Digital-Blocks-design/open_jtag_smt3/README.md

# open_jtag_smt3

已经过量产验证的 digilent jtag_smt3 仿真器开源版本 ，支持xilinx FPGA调试以及URAT接口 。
