Digital-Blocks-design/open_jtag_smt3/tools/USB_JTAG编程文件/readme.md

# USB_JTAG编程文件使用说明

【2024年2月10日】

如下图所示 ，该文件夹下有两个版本的编程文件，版本号分别为 **V1.0** 和 **V1.1** 。

编程文件

 **V1.0** 和 **V1.1** 的区别为用户自定义的仿真器编号定义不同 。

 **V1.0** ：用户需输入至少8个ASSCLL字符串 ，用作仿真器序列号 。

 **V1.1** ：用户需输入至少2个ASSCLL字符串 ，程序会计算当前日期的时间，并自动填充到仿真器序列号中 。

## V1.0 版本使用说明 :

1，通过USB线缆连接仿真器到电脑端 ，vivado软件的【HARDWARE MANAGER】功能需关闭。

2，（可选）使用 FT_Prog 工具检测电脑是否能够识别到器件。

3，双击运行【FT2232H EEPROM Modify.exe】程序 。

4，命令行窗口提示输入至少8个ASSCLL字符串（超过8个的字符串将被忽略）。

输入至少8个ASSCLL字符串

5，程序识别到2个设备 ，且两个设备的Type均为6 。

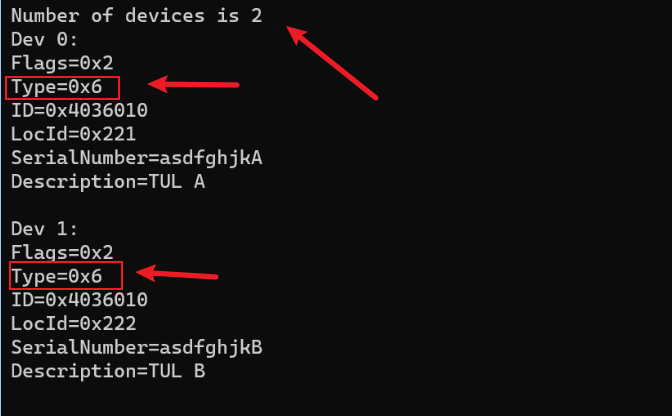
[picture p1: tools/USB_JTAG编程文件/image/图片2.png]
程序识别到2个设备


6，按下回车键，完成 EEPROM 程序烧录 ，终端显示 “Success write EEPROM”字符串 ，表示EEPROM 程序烧录成功 。

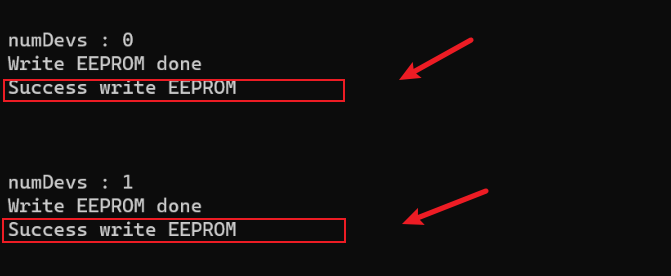
[picture p2: tools/USB_JTAG编程文件/image/图片3.png]
程序烧录成功


7，打开vivado软件，使用 【HARDWARE MANAGER】工具验证是否能识别到下载器工具 。

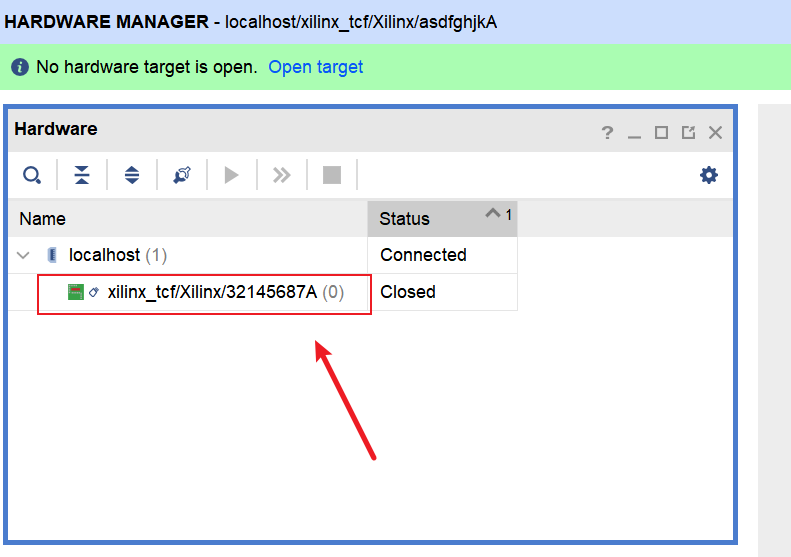
[picture p3: tools/USB_JTAG编程文件/image/图片4.png]
识别到下载器工具


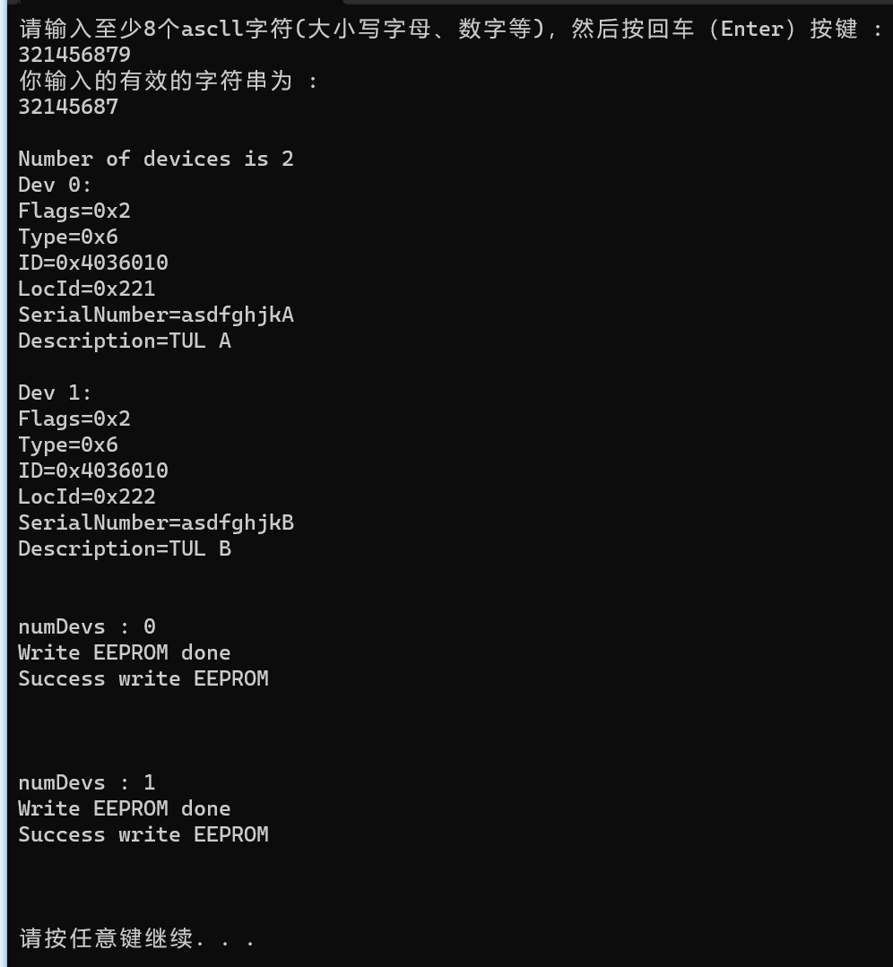
[picture p4: tools/USB_JTAG编程文件/image/图片5.png]
完整的编程日志
完整的编程日志如下 ：

## V1.1 更新内容 ： 

1. 命令行窗口提示输入至少2个ASSCLL字符串（超过2个的字符串将被忽略）。
2. 程序会计算当前日期的时间（年月日），并自动填充到仿真器序列号中 。
