Digital-Blocks-design/open_jtag_smt3/tools/USB_JTAG编程文件/使用说明.txt

【2023年10月26日12:13:39】
V1.0 ：
1，通过USB线缆连接仿真器到电脑端 ，vivado软件的【HARDWARE MANAGER】功能需关闭。
2，（可选）使用 FT_Prog 工具检测电脑是否能够识别到器件。
3，点击运行【FT2232H EEPROM Modify.exe】程序 。
4，命令行窗口提示输入至少8个ASSCLL字符串（超过8个的字符串将被忽略）。
5，按下回车键，完成 EEPROM 程序烧录 。
6，打开vivado软件，使用 【HARDWARE MANAGER】工具验证是否能识别到下载器工具 。

【2024年1月2日16:17:26】
V1.1 更新内容 ： 
命令行窗口提示输入至少2个ASSCLL字符串（超过2个的字符串将被忽略）。
程序会计算当前日期的时间（年月日），并自动填充到仿真器序列号中 。
