Digital-Blocks-design/open_jtag_smt3/doc/jtag-smt3-0.png

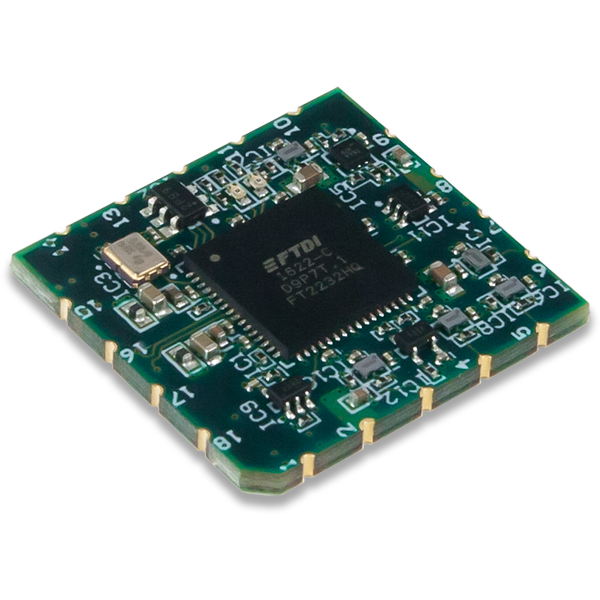
doc/jtag-smt3-0.png
