Digital-Blocks-design/open_jtag_smt3/doc/jtag-smt3-1.png

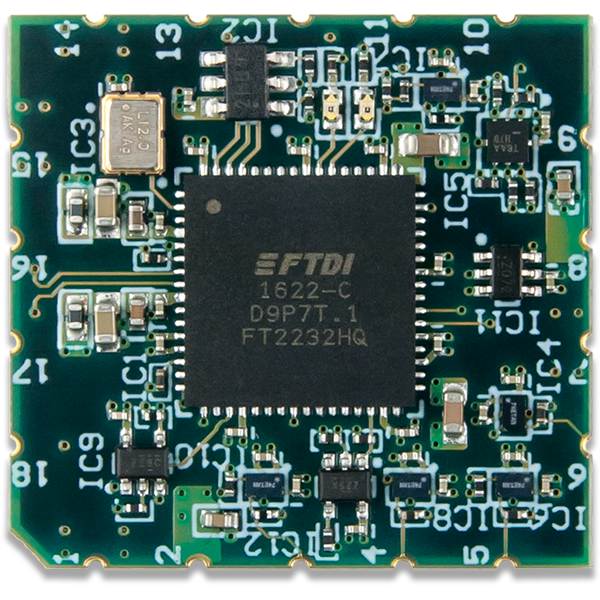
doc/jtag-smt3-1.png
