Digital-Blocks-design/open_jtag_smt3/doc/jtag-smt3-3.png

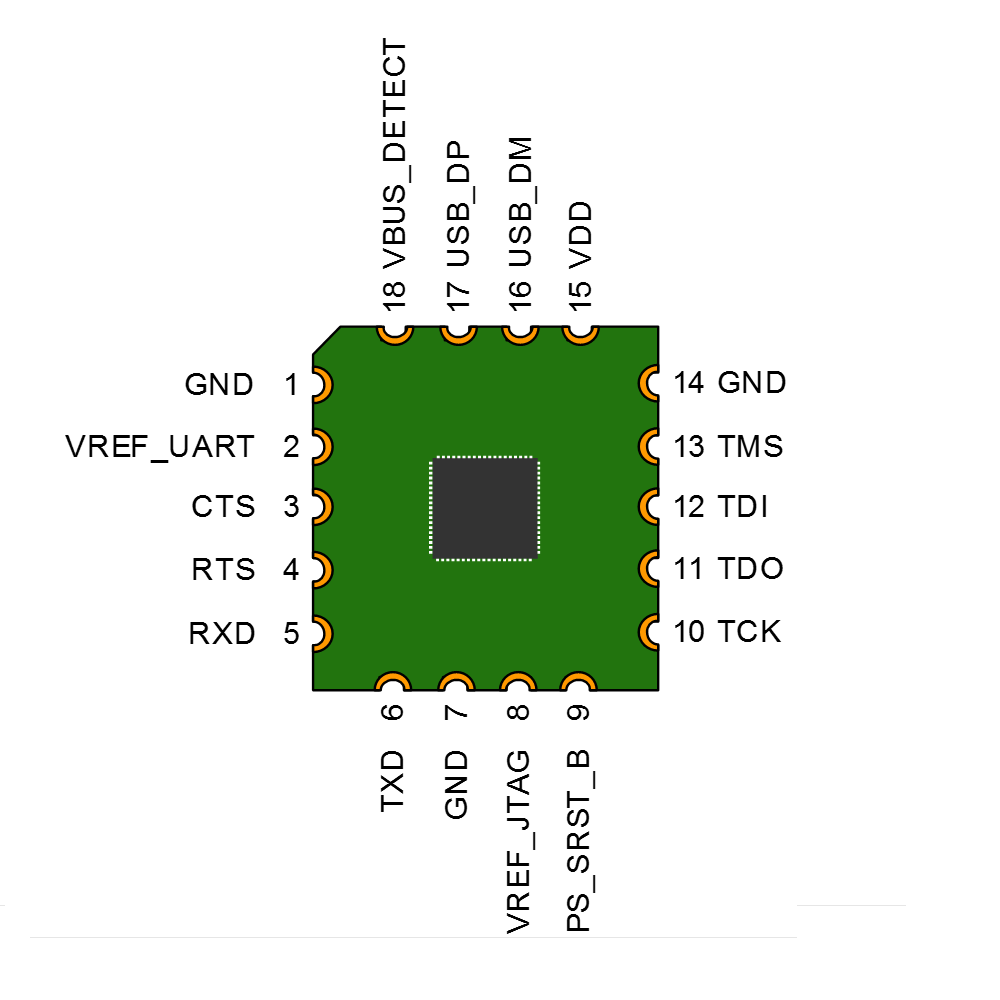
doc/jtag-smt3-3.png
