Digital-Blocks-design/open_jtag_smt3/hardware/image/JTAG插座结构/弯针/DC3弯针座_1.jpg

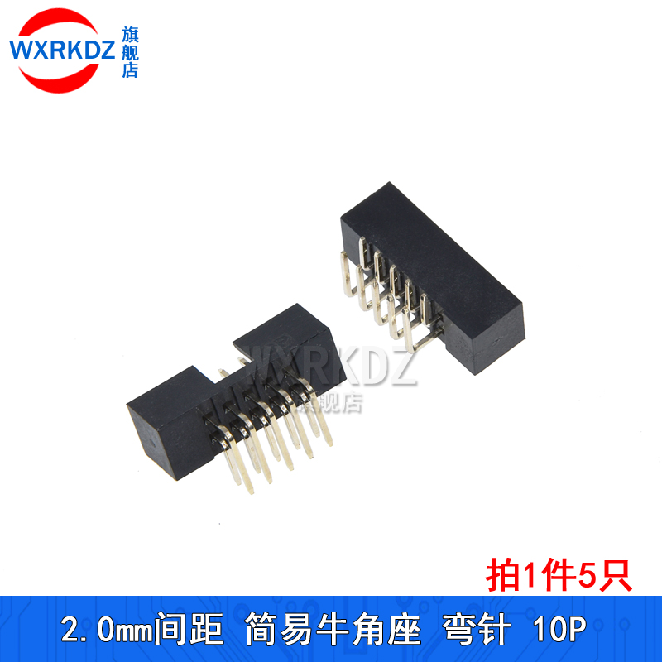
hardware/image/JTAG插座结构/弯针/DC3弯针座_1.jpg
