Digital-Blocks-design/open_jtag_smt3/hardware/image/JTAG插座结构/直针/DC3直针座_0.jpg

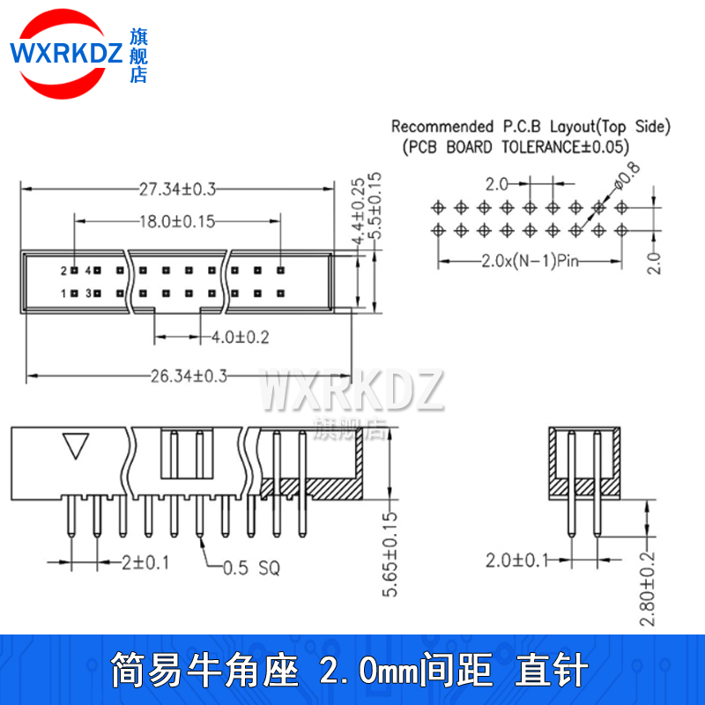
hardware/image/JTAG插座结构/直针/DC3直针座_0.jpg
