Digital-Blocks-design/open_jtag_smt3/hardware/image/USB_JTAG实物图_0.jpg

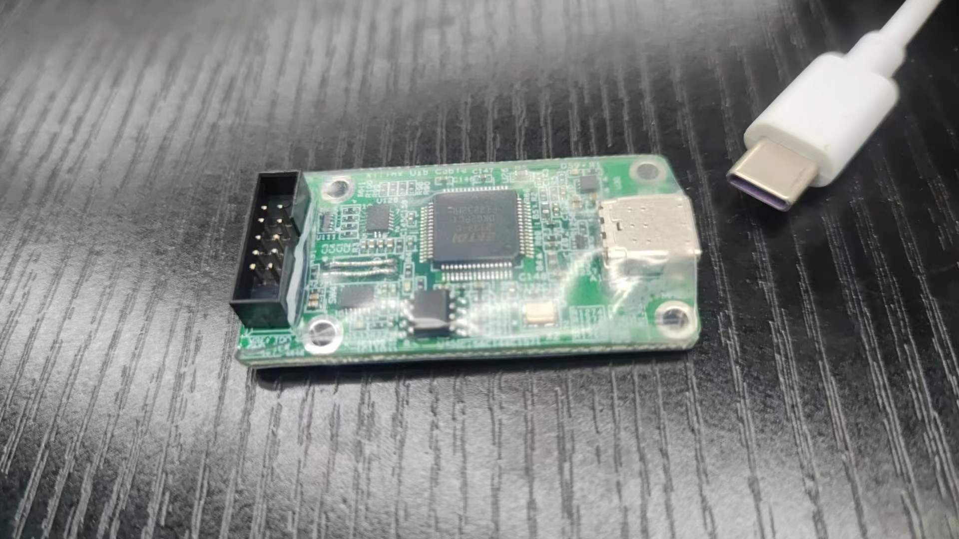
hardware/image/USB_JTAG实物图_0.jpg
