Digital-Blocks-design/open_jtag_smt3/hardware/image/USB_JTAG实物图_1.jpg

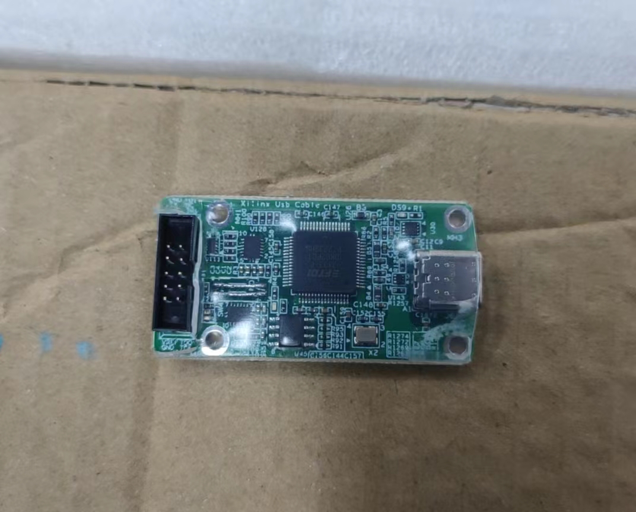
hardware/image/USB_JTAG实物图_1.jpg
