Digital-Blocks-design/open_jtag_smt3/hardware/PCB/PCB_TOP_1.png

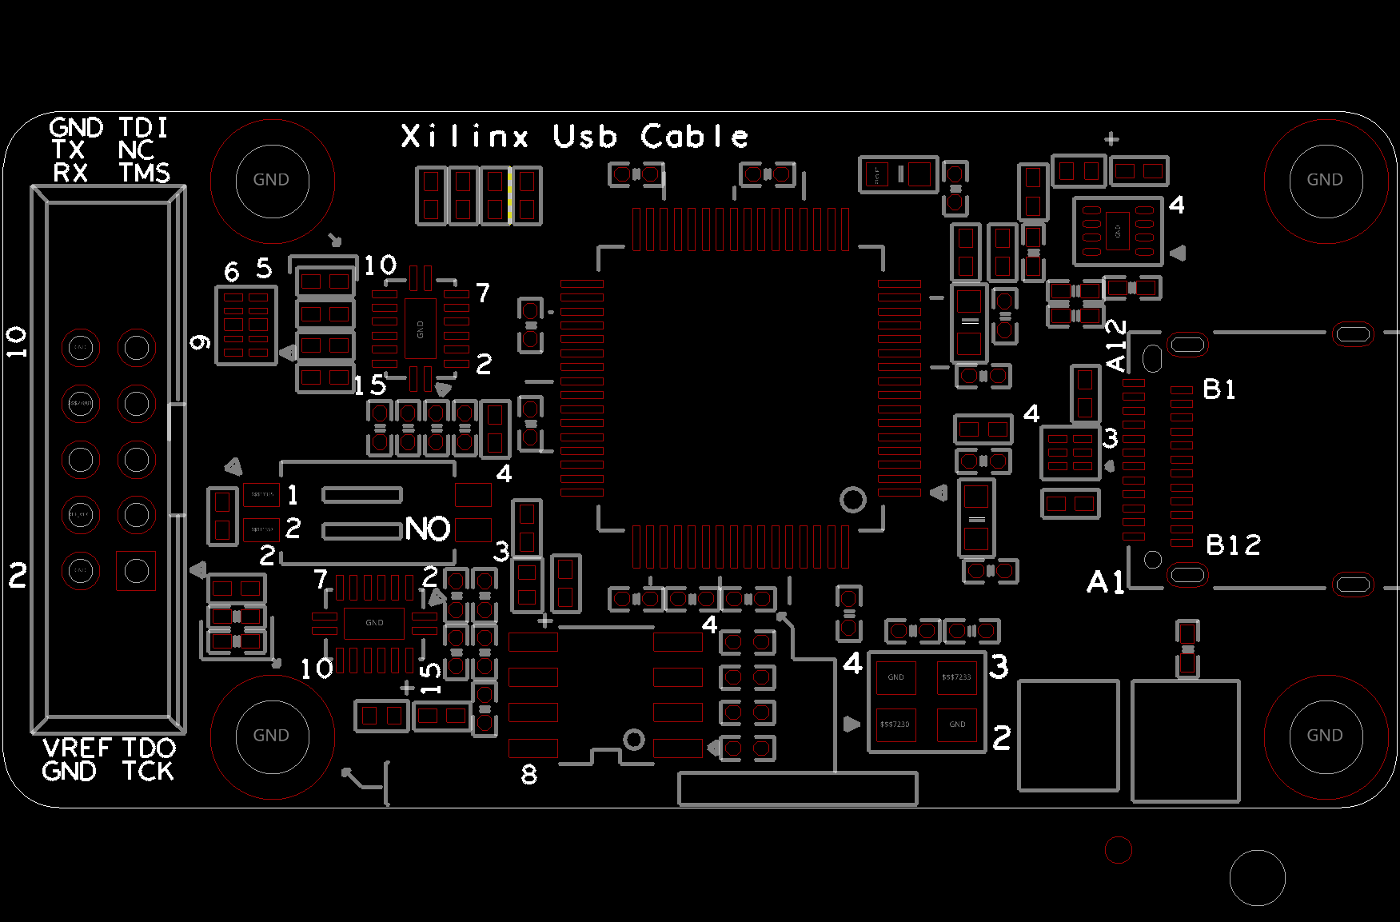
hardware/PCB/PCB_TOP_1.png
