Digital-Blocks-design/open_jtag_smt3/hardware/BOM/USB_JTAG_仿真器档BOM-20240131.csv

USB_JTAG 仿真器调试板 BOM
序号 | 物料名称 | 型号规格 | 参数（值） | 封装/材质 | 版本号/图号 | 位号 | 单板数量（整套） | 单位
板卡板号： XCY101_USB_JTAG_V1.0
1 | 电阻 | R0603,0R,25% |  | R0603 |  | B3 B4 B5 | 3 | 个
2 | USB连接器 | 12401598E4-2A |  |  |  | J6 | 1 | 个
3 | 集成电路 | 93LC56B,93LC56B |  | SOIC8P127W390 |  | U45 | 1 | 个
4 | 电容 | CAP0402,10uF DNP | 10uF | CAP0402 |  | C1672 | 1 | 个
5 | 电容 | CAP0402,0.01uF | 0.01uF | CAP0402 |  | C10 | 1 | 个
6 | 电容 | CAP0402,0.1uF | 0.1uF | CAP0402 |  | C1 C3 C5 C7 C143 C144 C145 C146 C147 C148 C149 C151 C153 C154 C156 C158 | 16 | 个
7 | 电容 | CAP0402,100pF | 100pF | CAP0402 |  | C6 C8 | 2 | 个
8 | 电容 | CAP0402,10uF | 10uF | CAP0402 |  | C2 C4 C157 C159 C12 C9 C11 C109 C110 | 9 | 个
11 | 电容 | CAP0402,27PF | 27PF | CAP0402 |  | C152 C155 | 2 | 个
12 | 晶振 | FA238,12.00MHZ,20PPM | 12.00MHZ,20PPM | XTAL_EPSON_FA238 |  | X2 | 1 | 个
13 | 集成电路 | FT2232HL |  | LQFP_64 |  | U26 | 1 | 个
14 | 集成电路 | FXL4TD245BQX |  | DQFN16-0_5-3_5X2_5-H0_8 |  | U43 U128 | 2 | 个
15 | 螺钉孔 | HOLE4_5-2_7MM,DNP |  |  |  | MH1 MH2 MH3 MH4 | 4 | 个
16 | JTAG插座 | JTAG_10P |  | DC3-10P,2.00间距 |  | JT1 | 1 | 个
17 | LED灯 | LED_0402 |  | LED0402 |  | DS33 DS49 DS9 | 2 | 个
19 | 集成电路 | MAX8902BATA+ |  | TDFN2MMX2MM |  | U30 | 1 | 个
20 | 集成电路 | RCLAMP0524P |  | DFN10-0_5-2_6X1_1-H0_65 |  | U111 | 1 | 个
21 | 电阻 | RES0402,0R | 0R | RES0402 |  | R3 R4 R1265 R1269 R1272 R1274 | 6 | 个
23 | 电阻 | RES0402,100R | 100R | RES0402 |  | R22 R136 | 2 | 个
24 | 电阻 | RES0402,10K | 10K | RES0402 |  | R91 R92 R93 | 3 | 个
25 | 电阻 | RES0402,12k | 12k | RES0402 |  | R89 | 1 | 个
26 | 电阻 | RES0402,18.2K | 18.2K | RES0402 |  | R2 | 1 | 个
27 | 电阻 | RES0402,1K | 1K | RES0402 |  | R86 | 1 | 个
28 | 电阻 | RES0402,2K | 2K | RES0402 |  | R95 | 1 | 个
29 | 电阻 | RES0402,33R | 33R | RES0402 |  | R27 R31 | 2 | 个
30 | 电阻 | RES0402,4.02K | 4.02K | RES0402 |  | R5 | 1 | 个
31 | 电阻 | RES0402,4.7K | 4.7K | RES0402 |  | R90 R98 R99 R100 R1 | 5 | 个
33 | 电阻 | RES0402,5.11K | 5.11K | RES0402 |  | R1257 R1258 | 2 | 个
34 | 集成电路 | TDA02H0SB1,DNP |  | SW8-1_27-TDA04H0SB1R |  | U1 | 1 | 个
35 | 集成电路 | TPD4S012 |  | DFN6-0_5-1_5X1_05-H0_6 |  | U143 | 1 | 个
