Digital-Blocks-design/open_jtag_smt3/refence_design/opi_link_X_standard-sch.pdf

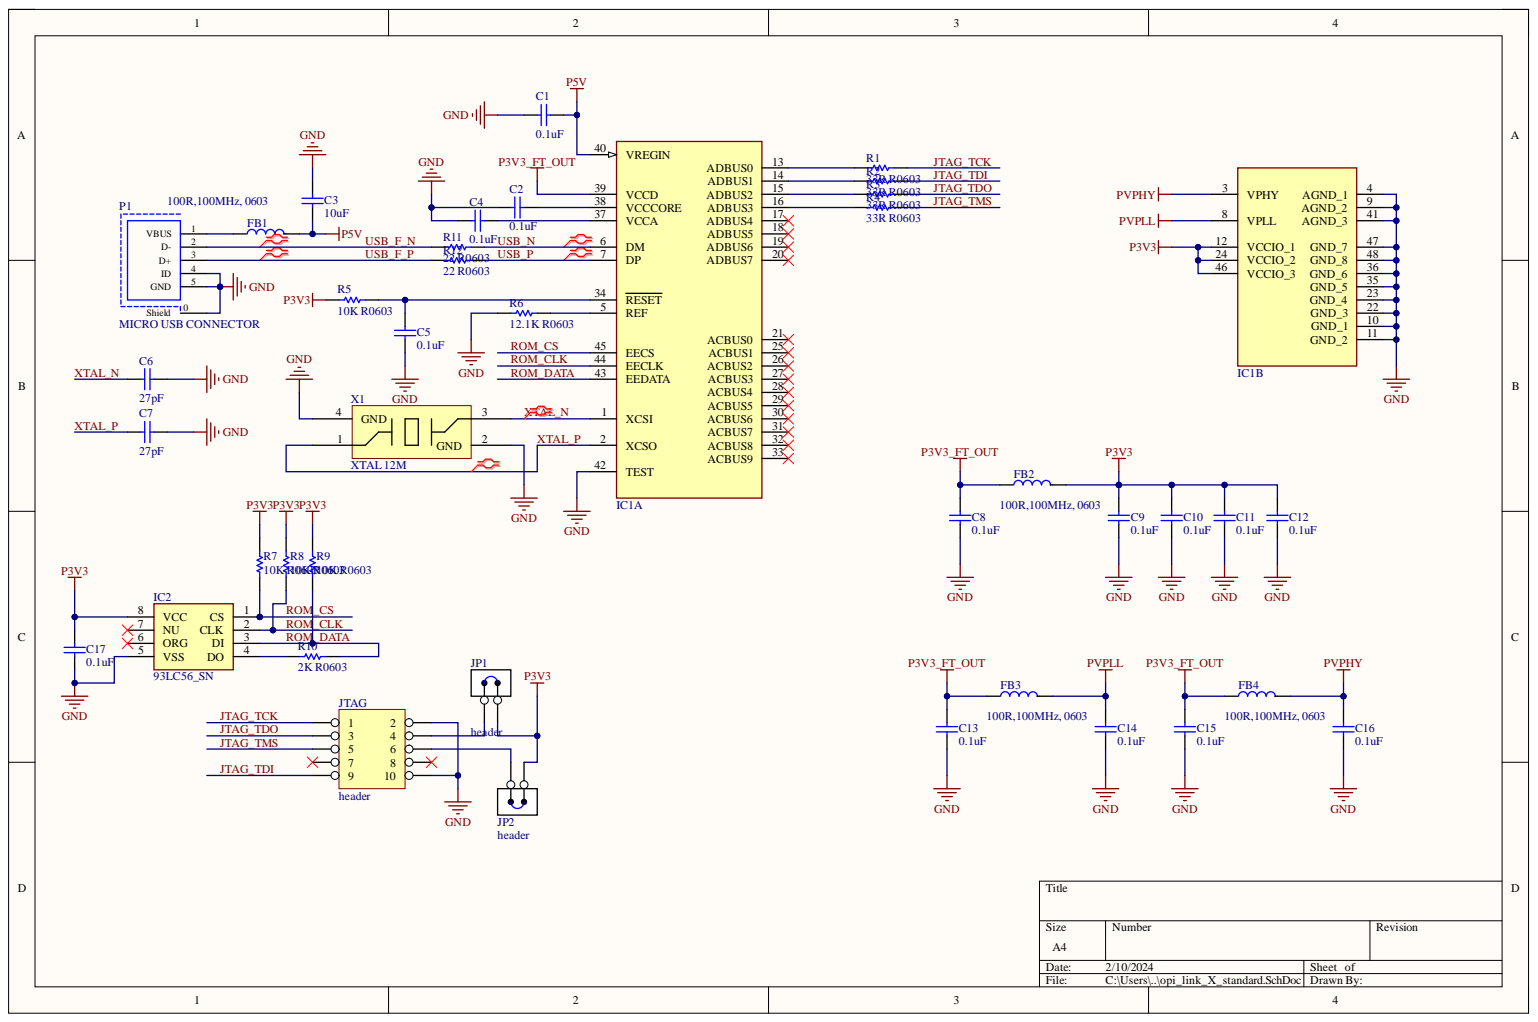
[picture p33: page 1]
