Digital-Blocks-design/open_jtag_smt3/refence_design/ft2232-hl-smt3-sch.pdf

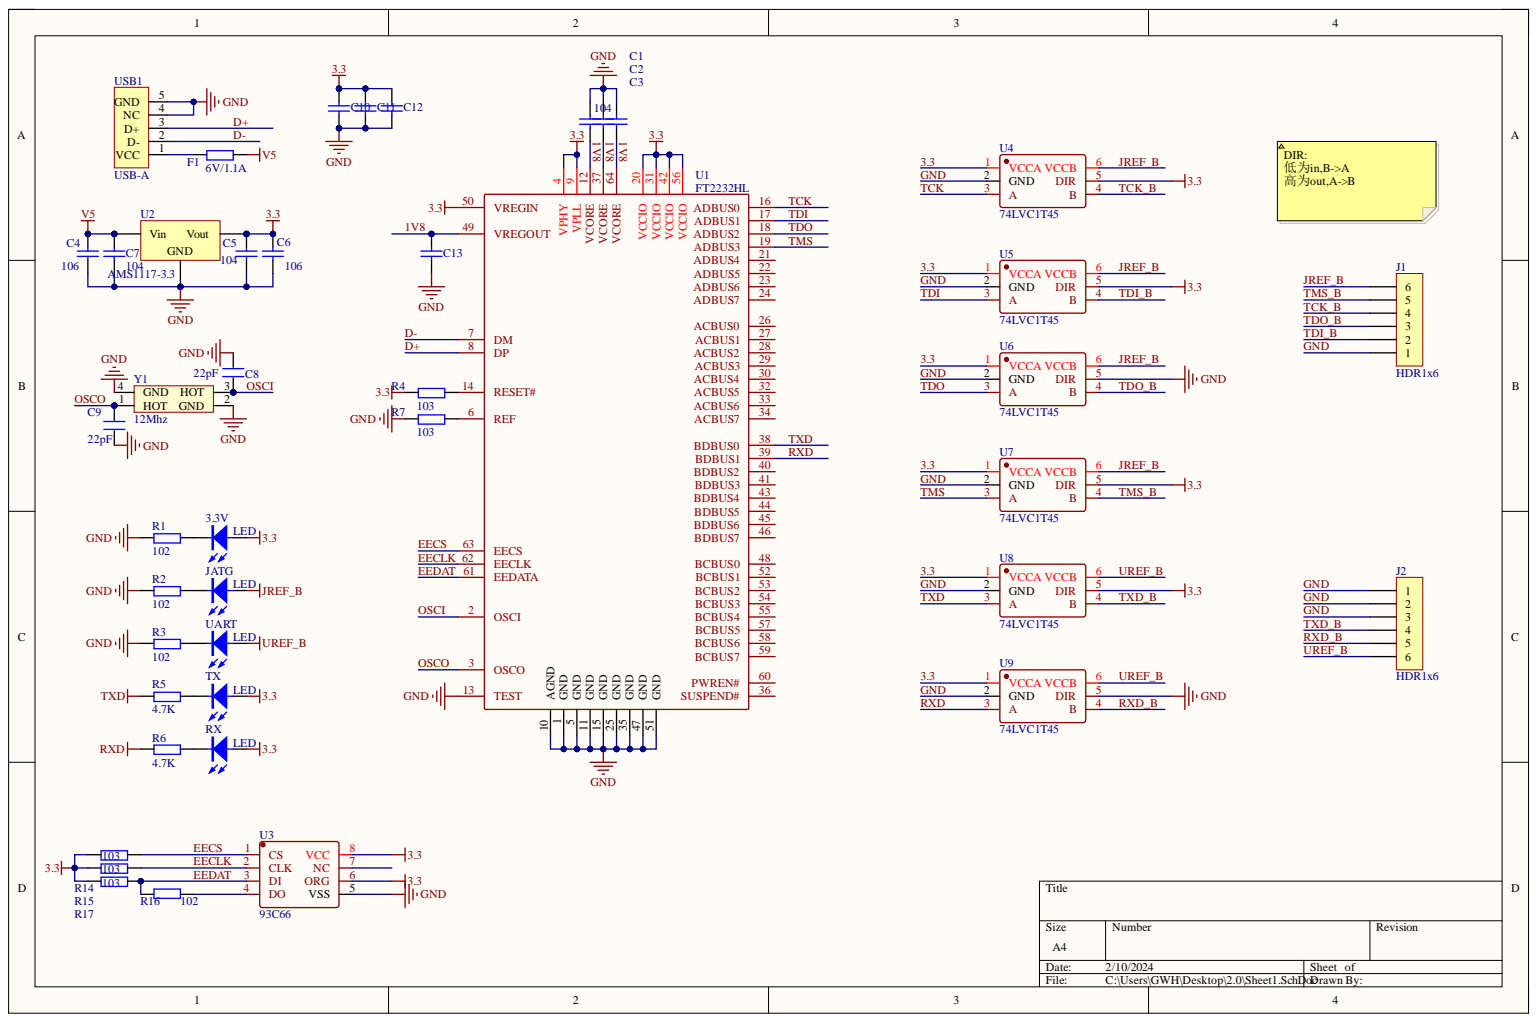
[picture p34: page 1]
