Digital-Blocks-design/open_jtag_smt3/hardware/SCH/USB_JTAG_20220624_2.pdf

## T_R0_NÎªµÍµçÆ½Ê±£ºBµ½A£»Îª¸ßµçÆ½Ê±Aµ½B

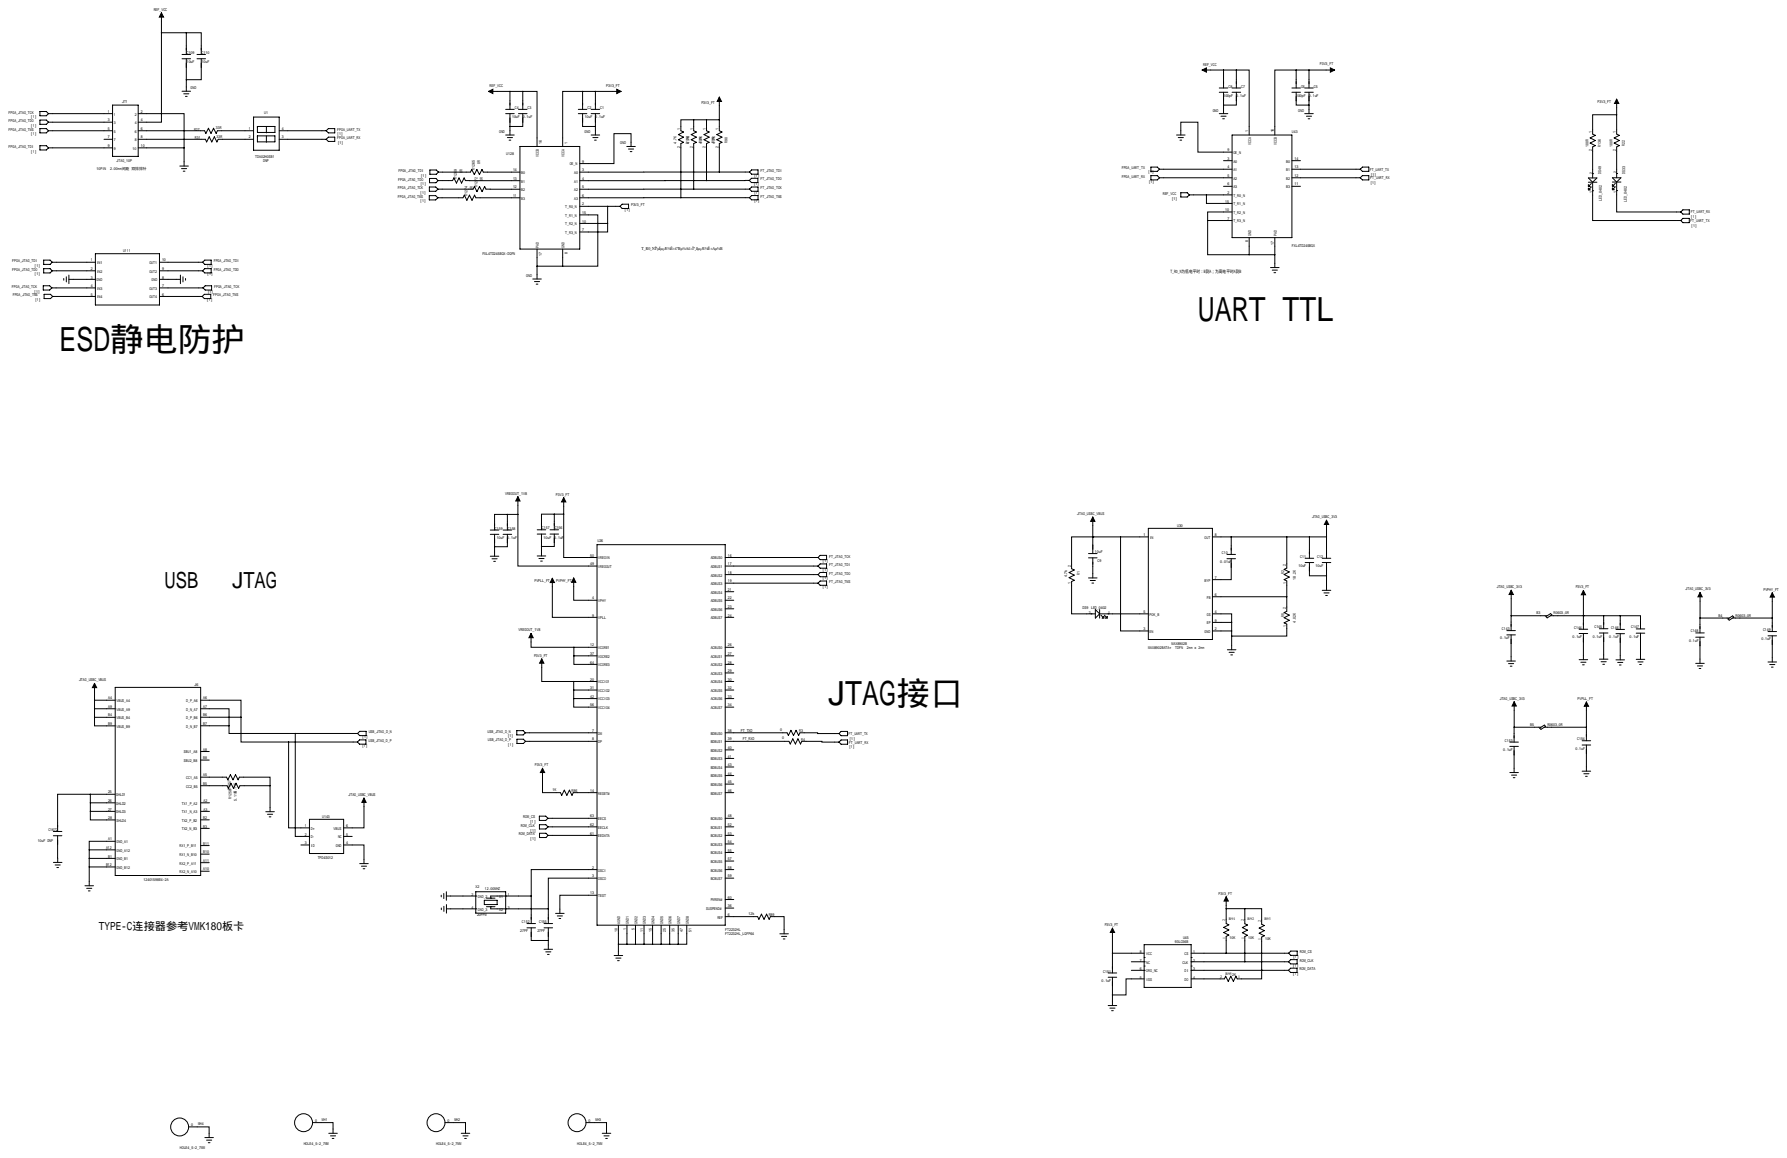
[picture p35: page 1]
