Digital-Blocks-design/open_jtag_smt3/(commit log)

2024-02-09 初始化版本 。
    带UART接口的xilinx JTAG模块 。
2024-02-09 添加修改文档资料 。
    jtag-smt3-nc-rm.pdf ：digilent的jtag-smt3-nc模块使用文档 。
    DS_FT2232H.pdf : FT2232H的芯片手册 。
2024-02-09 添加 digilent 官方编程工具 。
2024-02-09 添加 jtag-smt3 相关图片 。
    图片来源 ： https://digilent.com/reference/programmers/jtag-smt3/reference-manual
2024-02-09 添加 ft2232-hl-smt3 参考设计 。
    文件原网址为 ： https://gitee.com/miraikkiri/ft2232-hl-smt3
2024-02-09 添加 TT_Digilent_JTAG_HS2 参考设计 。
    文件原网址 ： https://github.com/TerayTech/TT_Digilent_JTAG_HS2
2024-02-09 添加子模块描述文件 。
2024-02-09 添加JTAG插座（DC3简易牛角座）实物图片 。
2024-02-09 添加 ft2232-hl-smt3 的PDF版本原理图文件 。
2024-02-09 添加 TT_Digilent_JTAG_HS2 的PDF版本原理图文件 。
2024-02-09 移动 digilent 软件工具位置 。
2024-02-09 添加USB_JTAG仿真器的编程工具 。
    【注意】V1.0 和 V1.1 版本的仿真器编号定义不相同 ，详细区别请参考“使用说明.txt” 文档 。
2024-02-09 添加 USB_JTAG 仿真器的实物图片和PCB图片 。
2024-02-09 重命名USB_JTAG的实物图片文件名 。
2024-02-09 添加 USB_JTAG 的PCB源文件 。
2024-02-09 添加 USB_JTAG 的光绘制版文件 。
    [art_param.txt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]
2024-02-09 修改光绘文件夹名称。 添加USB_JTAG引脚定义文件 。
    [USB_JTAG_仿真器档BOM-20240131.csv, art_param.txt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]
2024-02-09 添加光绘文件的压缩包 。
2024-02-09 添加USB_JTAG原理图的PDF版本文件 。
2024-02-10 移动图片位置 。
2024-02-10 添加编程文件的使用图片说明 。
2024-02-10 添加编程文件的使用说明文档 。
2024-02-10 添加相关的参考文档 。
2024-02-10 更新BOM ， 添加器件封装尺寸和参数值 。
    [USB_JTAG_仿真器档BOM-20240131.csv]
2024-02-10 更新 README.md 文件 。
2024-02-16 添加 jtag-smt3 的官方介绍文档 。
